maxwellbtyler29/hexapod-robot/docs/README.md

# Docs

| File | What it is |
| --- | --- |
| [`six-leg-setup.md`](six-leg-setup.md) | Current firmware v6 notes, wiring table, and the dated six-leg bring-up log |
| [`control.md`](control.md) | What the walking controller actually does |
| [`bench/`](bench/) | Earlier bench logs: USB/I²C bring-up, one servo, then one leg |
| [`images/`](images/) | Outdoor photo, print renders, and controller screenshots used in the README |

Build and upload steps are in [`../firmware/README.md`](../firmware/README.md).
