maxwellbtyler29/hexapod-robot/docs/images/controller/hexapod-hologram-preview.png

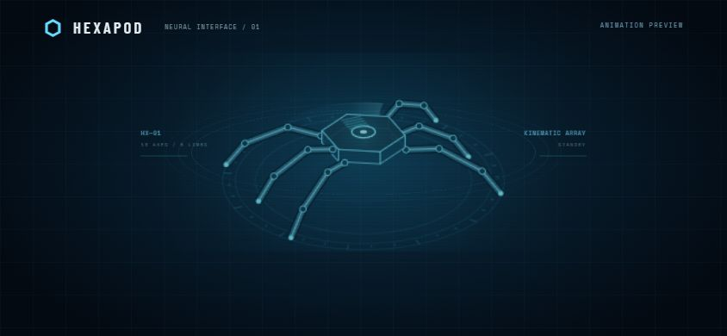
docs/images/controller/hexapod-hologram-preview.png
