maxwellbtyler29/hexapod-robot/docs/images/controller/hexapod-ready-walk-preview.png

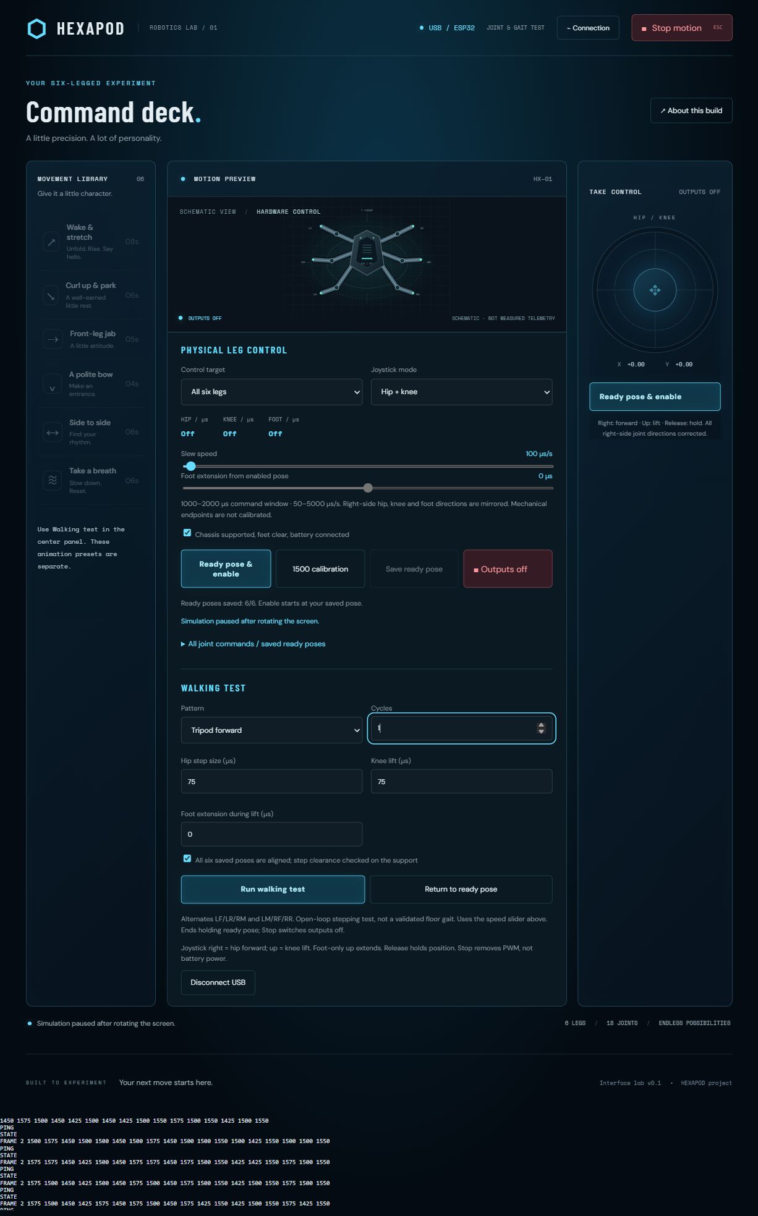
docs/images/controller/hexapod-ready-walk-preview.png
