maxwellbtyler29/hexapod-robot/docs/images/controller/hexapod-startup-preview.png

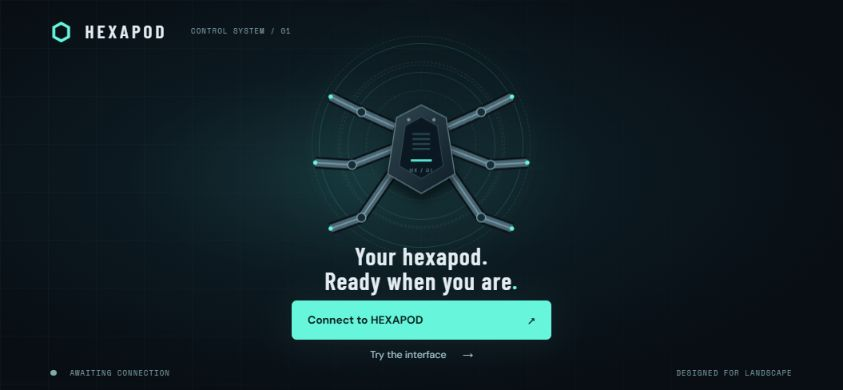
docs/images/controller/hexapod-startup-preview.png
