maxwellbtyler29/hexapod-robot/docs/images/controller/hexapod-usb-controls-preview.png

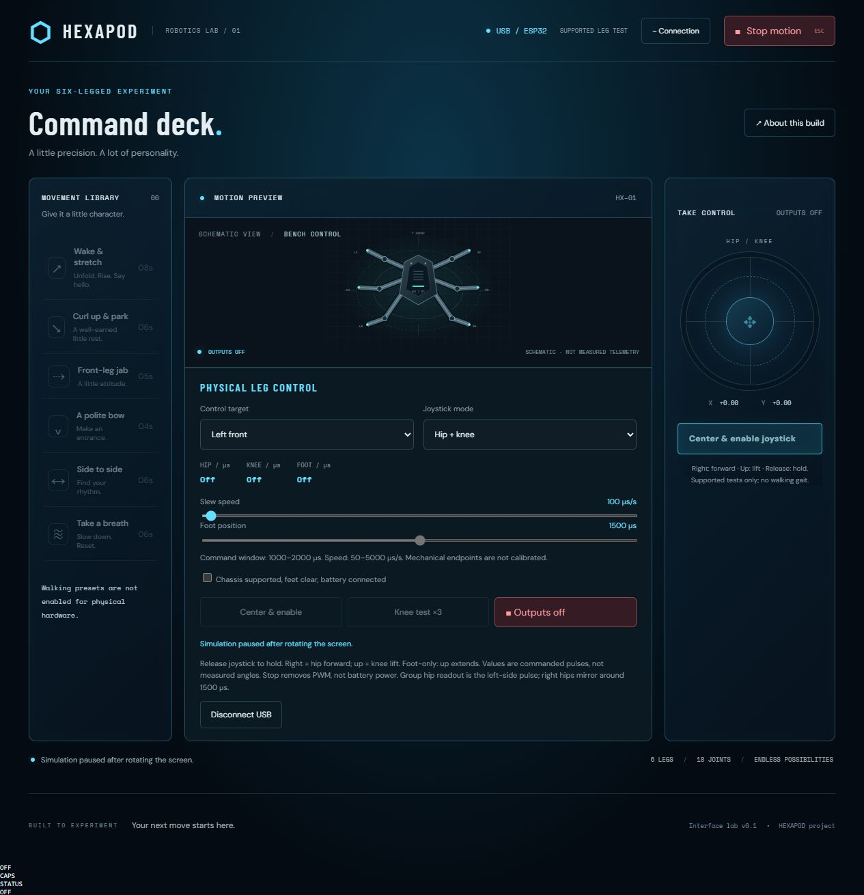
docs/images/controller/hexapod-usb-controls-preview.png
