maxwellbtyler29/hexapod-robot/simulation/gait/trim/peak_torque_comparison.png

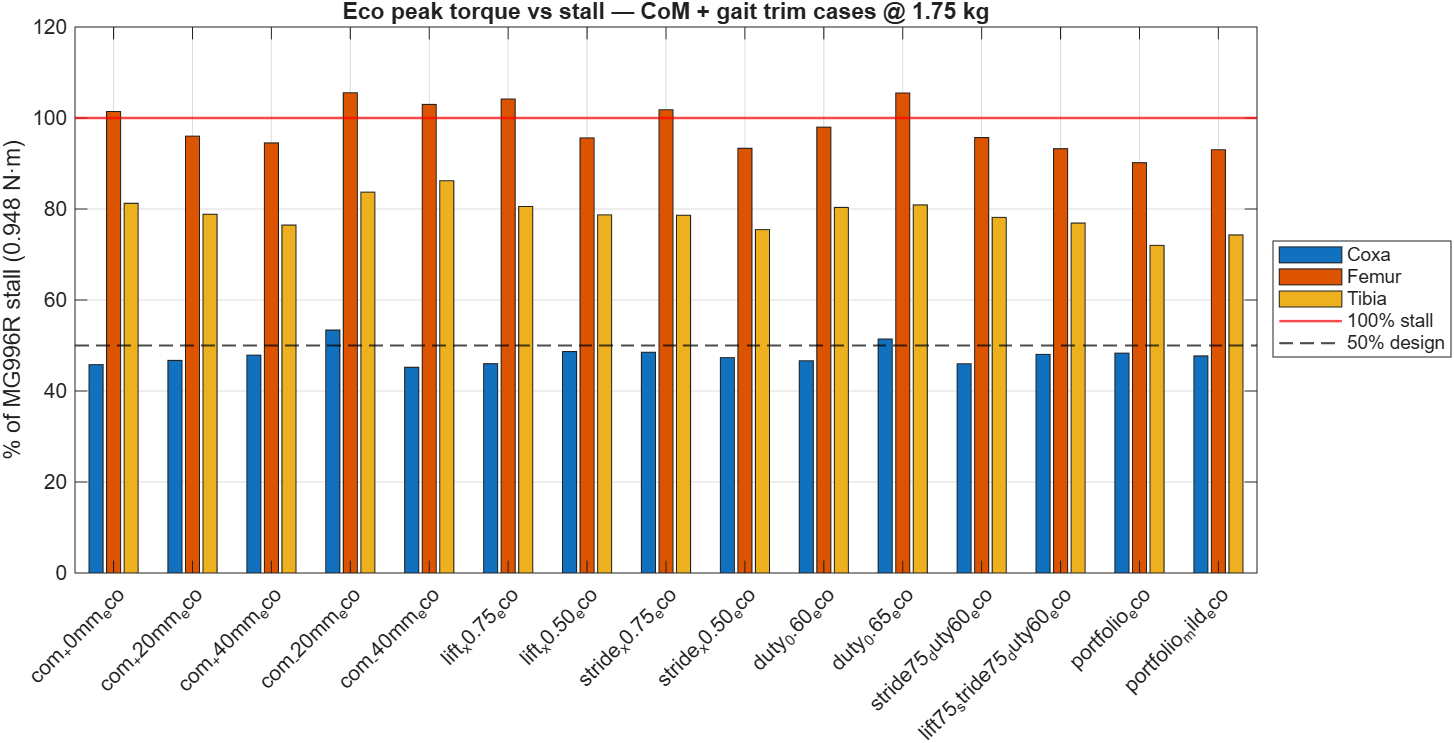
simulation/gait/trim/peak_torque_comparison.png
