maxwellbtyler29/hexapod-robot/cad/assemblies/simscapeHexapodassembly.SLDASM

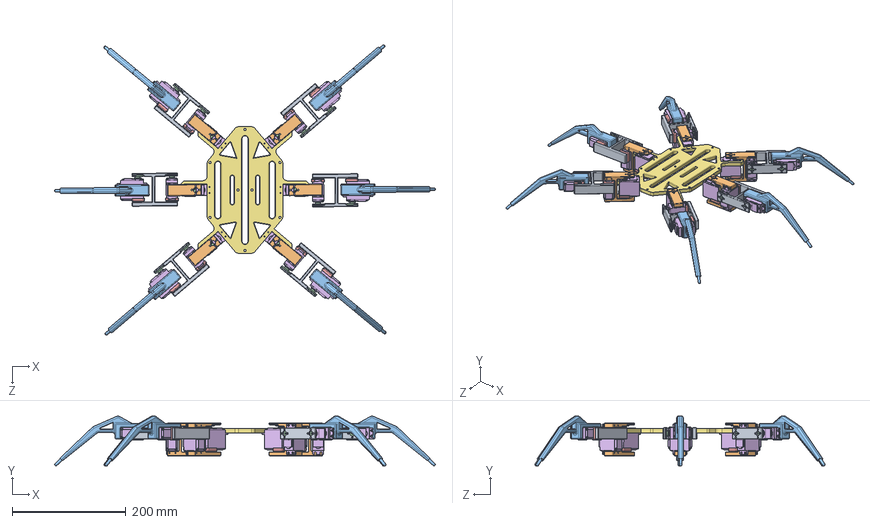
[picture p15: CAD file, 2026-11-10]
cad/assemblies/simscapeHexapodassembly.SLDASM
669.4 x 87.8 x 510.3 mm
Hexapod body (top)
MG996R_servo x 18
Opposite support for servo x 18
Servo Horn x 18
Leg and servo 3 mount x 6
Servo1 to Servo 2 connector x 6
Servo2 to Servo3 Connector x 6
