maxwellbtyler29/hexapod-robot/cad/assemblies/Full Body assembly.SLDASM

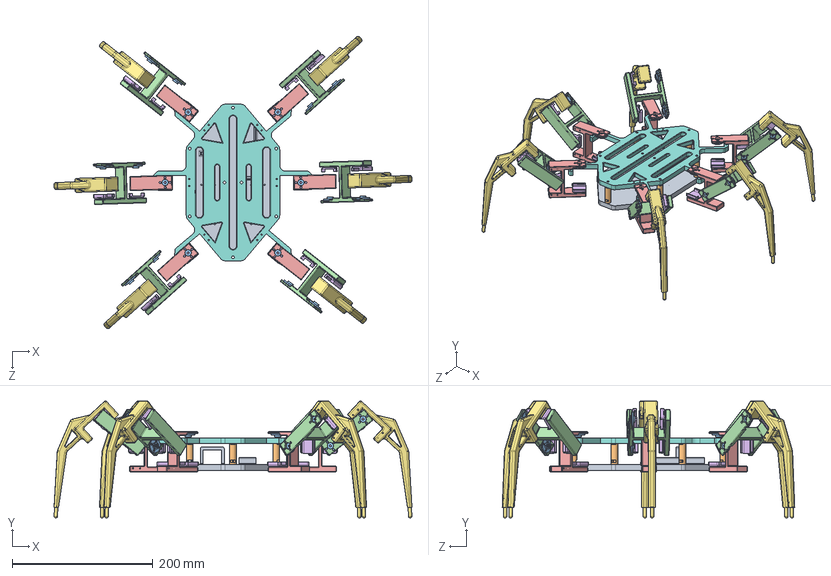
[picture p16: CAD file, 2026-11-10]
cad/assemblies/Full Body assembly.SLDASM
508.6 x 166.0 x 415.5 mm
Hexapod body (top)
Leg and servo 3 mount x 6
Opposite support for servo x 18
Servo1 to Servo 2 connector x 6
Servo2 to Servo3 Connector x 6
Servo Horn x 18
Body Supports x 6
Hexapod body(bottom)
