maxwellbtyler29/hexapod-robot/cad/components/Complete servo assembly.SLDASM

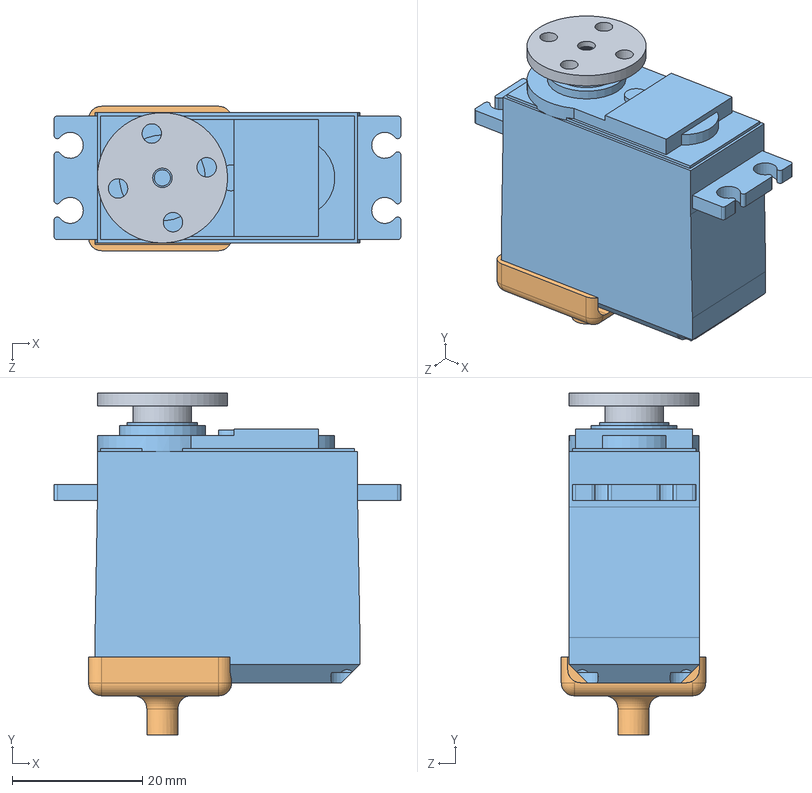
[picture p17: CAD file, 2026-11-10]
cad/components/Complete servo assembly.SLDASM
53.3 x 52.5 x 22.2 mm
MG996R_servo
Opposite support for servo
Servo Horn
