maxwellbtyler29/hexapod-robot/cad/assemblies/One leg assembly.SLDASM

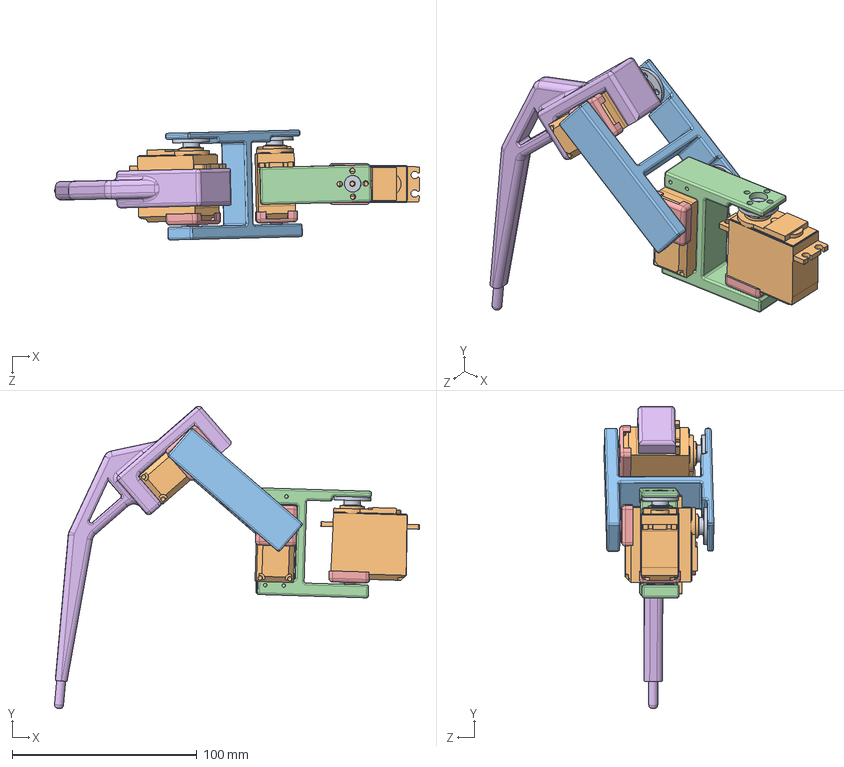
[picture p18: CAD file, 2026-11-10]
cad/assemblies/One leg assembly.SLDASM
197.7 x 163.8 x 59.5 mm
Leg and servo 3 mount
Opposite support for servo x 3
Servo1 to Servo 2 connector
Servo2 to Servo3 Connector
MG996R_servo x 3
Servo Horn x 3
