maxwellbtyler29/hexapod-robot/cad/assemblies/Simscape one leg assembly.SLDASM

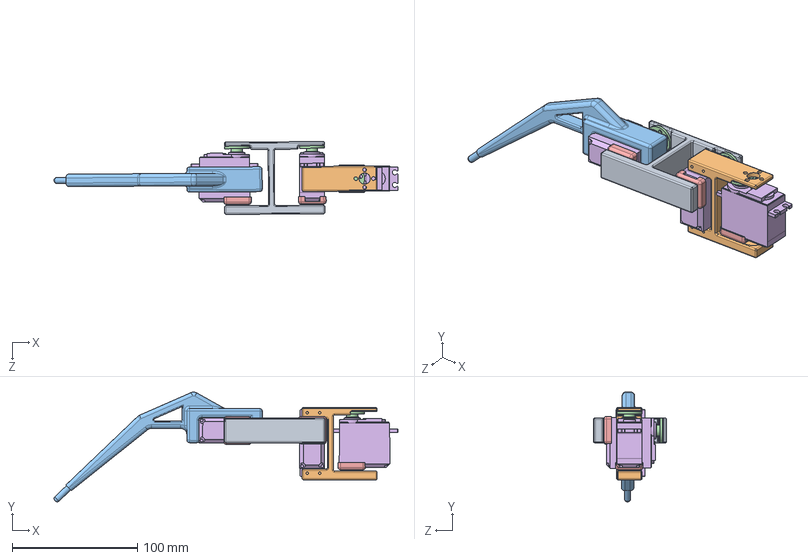
[picture p19: CAD file, 2026-11-10]
cad/assemblies/Simscape one leg assembly.SLDASM
274.9 x 87.8 x 58.3 mm
MG996R_servo x 3
Opposite support for servo x 3
Servo Horn x 3
Leg and servo 3 mount
Servo1 to Servo 2 connector
Servo2 to Servo3 Connector
