maxwellbtyler29/hexapod-robot/cad/components/MG996R_servo.SLDPRT

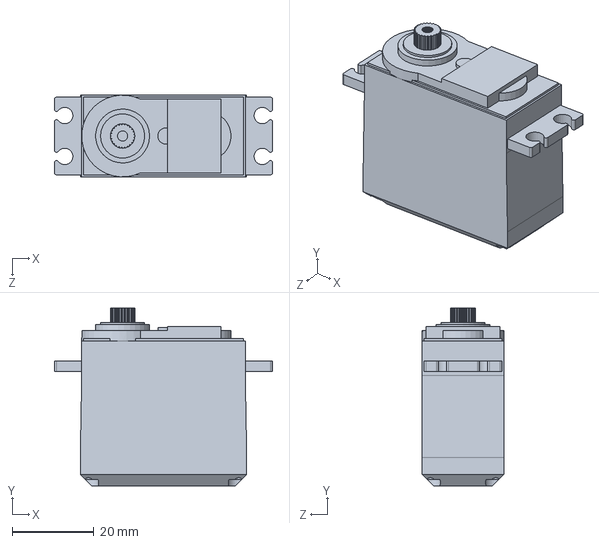
[picture p20: CAD file, 2026-11-10]
cad/components/MG996R_servo.SLDPRT
53.3 x 43.5 x 20.0 mm
