maxwellbtyler29/hexapod-robot/cad/parts/Hexapod body(bottom).SLDPRT

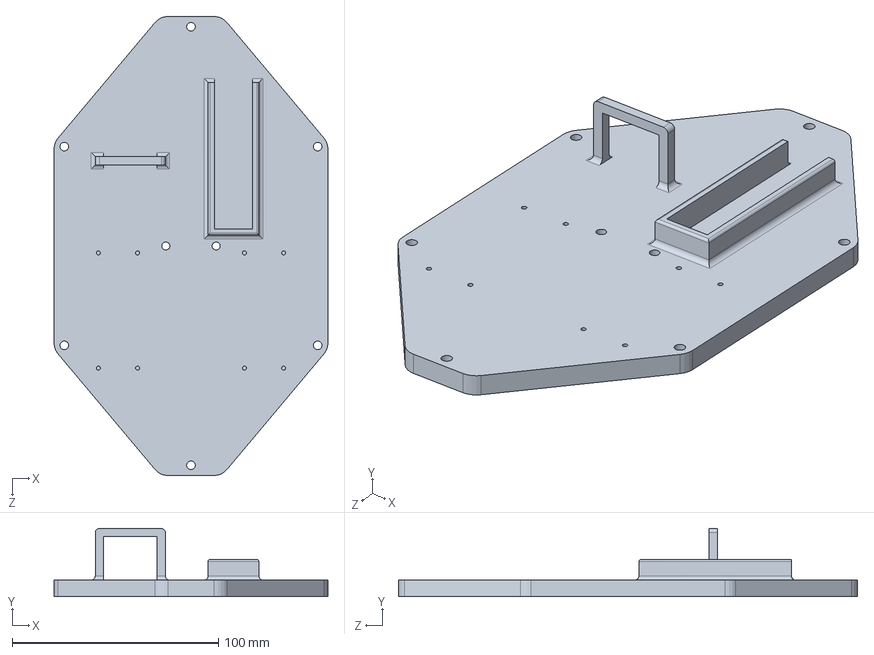
[picture p21: CAD file, 2026-11-10]
cad/parts/Hexapod body(bottom).SLDPRT
132.8 x 33.0 x 222.6 mm
