maxwellbtyler29/hexapod-robot/cad/print/opposite-servo-support.stl

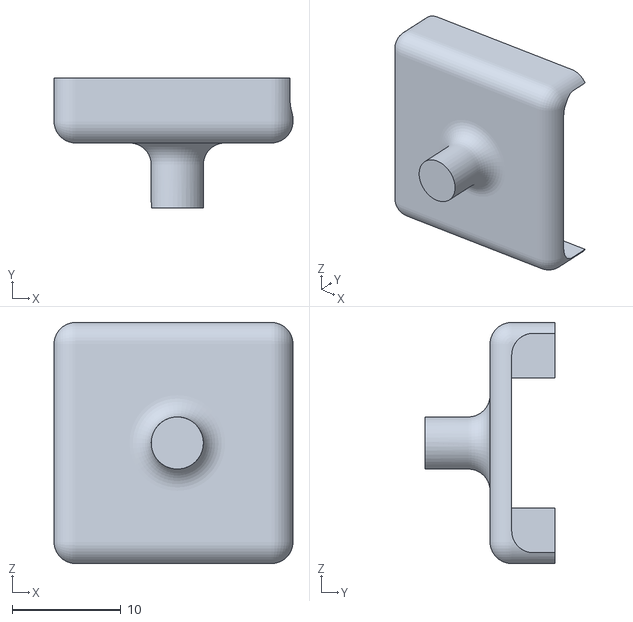
[picture p22: CAD file, 2026-11-10]
cad/print/opposite-servo-support.stl
22.0 x 12.0 x 22.2
