maxwellbtyler29/hexapod-robot/cad/parts/Body Supports.SLDPRT

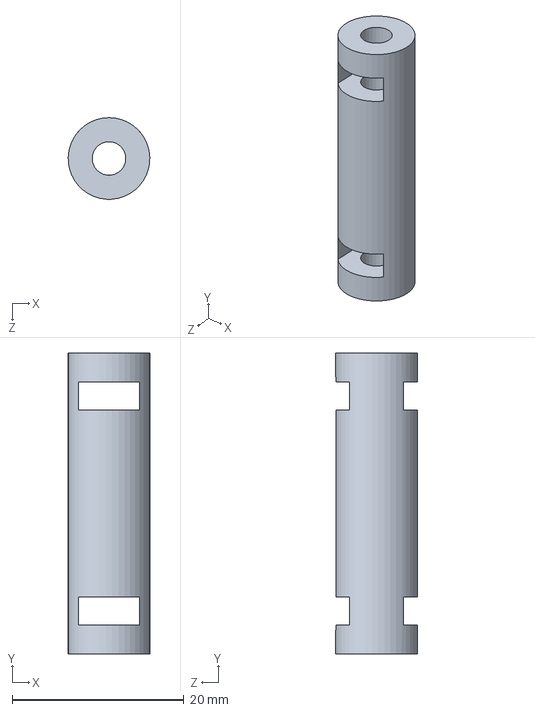
[picture p23: CAD file, 2026-11-10]
cad/parts/Body Supports.SLDPRT
9.49 x 35.0 x 9.50 mm
