maxwellbtyler29/hexapod-robot/cad/print/print-plates.3mf

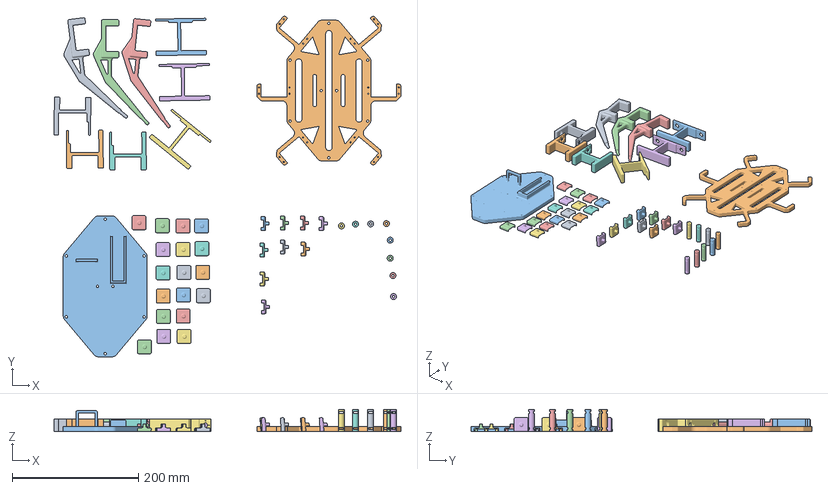
[picture p24: CAD file, 2026-11-10]
cad/print/print-plates.3mf
548.7 x 538.6 x 35.0 mm
leg-and-servo3-mount_mirror.stl x 3
servo1-to-servo2-connector_mirror.stl x 3
servo2-to-servo3-connector_mirror.stl x 3
hexapod-body-top.stl
hexapod-body-bottom.stl
opposite-servo-support.stl x 27
body-supports.stl x 8
