maxwellbtyler29/hexapod-robot/simulation/simscape/servo1-to-servo-2-connector.step

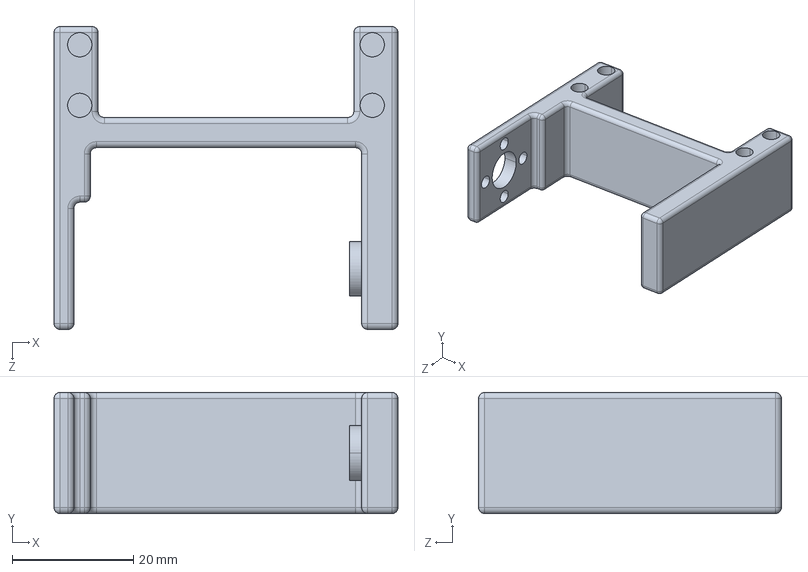
[picture p25: CAD file, 2026-11-10]
simulation/simscape/servo1-to-servo-2-connector.step
56.8 x 20.0 x 50.0 mm
