maxwellbtyler29/hexapod-robot/cad/components/PCA9685.SLDPRT

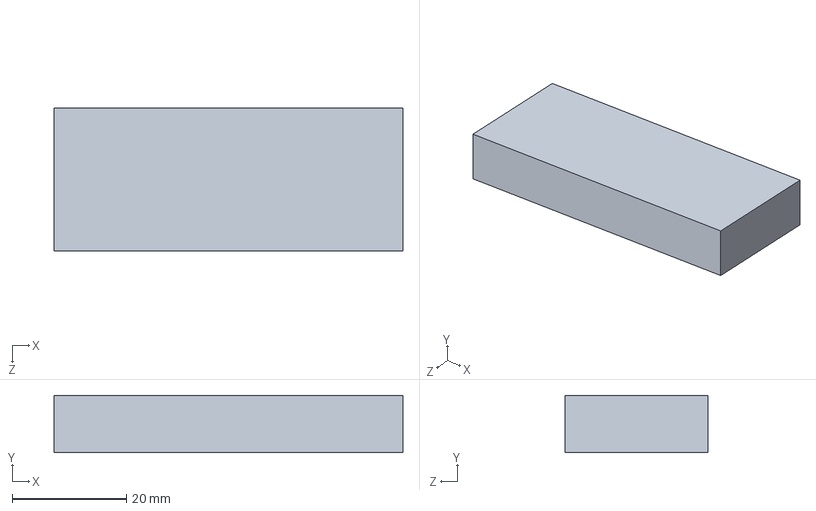
[picture p26: CAD file, 2026-11-10]
cad/components/PCA9685.SLDPRT
61.0 x 10.0 x 25.0 mm
