maxwellbtyler29/hexapod-robot/cad/parts/Leg and servo 3 mount mirror.SLDPRT

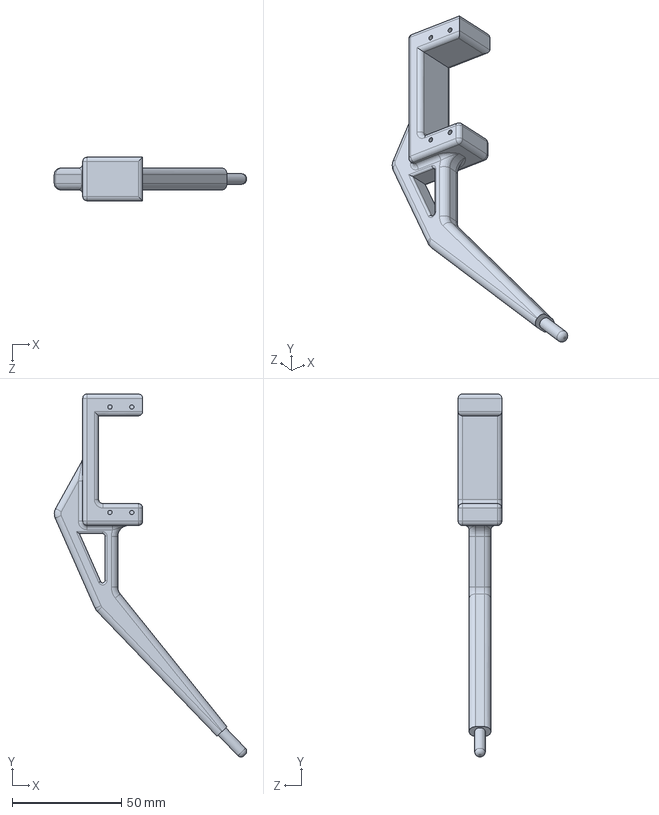
[picture p27: CAD file, 2026-11-10]
cad/parts/Leg and servo 3 mount mirror.SLDPRT
88.2 x 166.2 x 20.0 mm
