maxwellbtyler29/hexapod-robot/cad/print/left-legs-print-plate.3mf

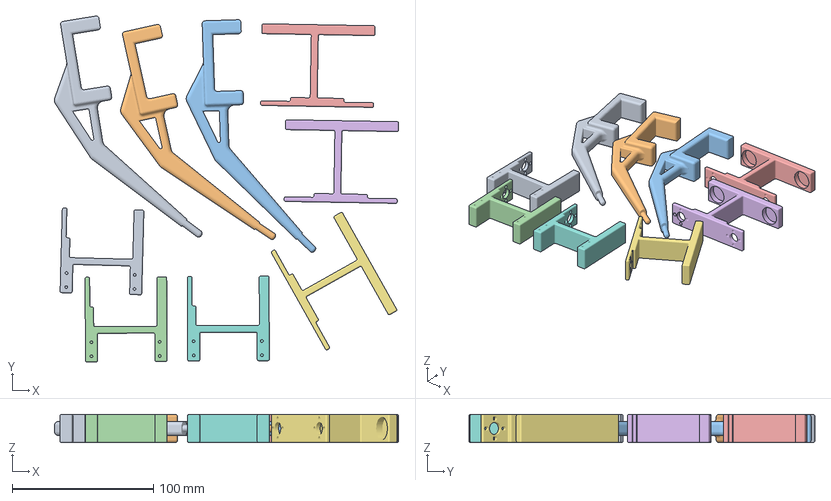
[picture p28: CAD file, 2026-11-10]
cad/print/left-legs-print-plate.3mf
243.6 x 244.8 x 20.0 mm
leg-and-servo3-mount.stl x 3
servo1-to-servo2-connector.stl x 3
servo2-to-servo3-connector.stl x 3
