maxwellbtyler29/hexapod-robot/simulation/simscape/leg-and-servo-3-mount.step

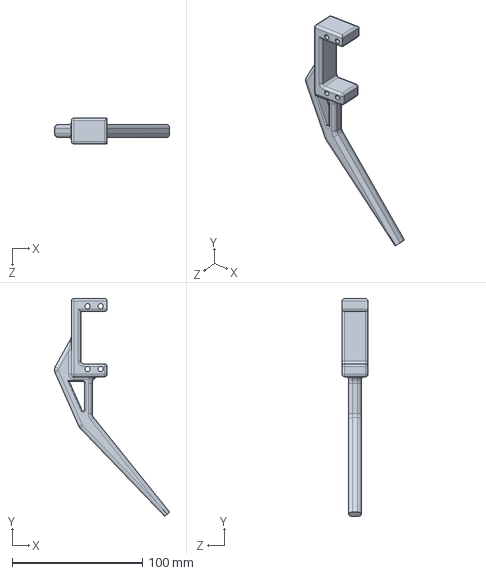
[picture p29: CAD file, 2026-11-10]
simulation/simscape/leg-and-servo-3-mount.step
88.5 x 167.6 x 20.0 mm
