maxwellbtyler29/hexapod-robot/cad/components/SBEC.SLDPRT

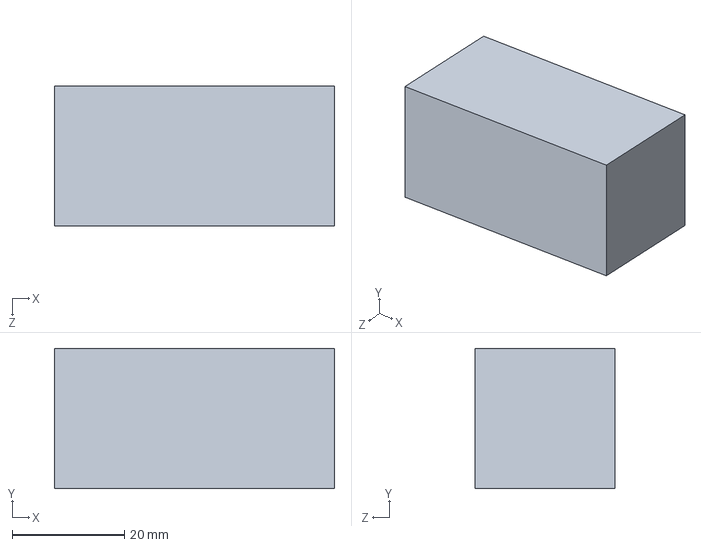
[picture p30: CAD file, 2026-11-10]
cad/components/SBEC.SLDPRT
50.0 x 25.0 x 25.0 mm
