maxwellbtyler29/hexapod-robot/simulation/simscape/hexapod-body-top.step

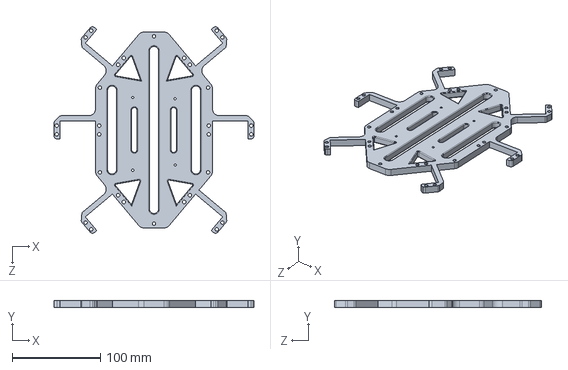
[picture p31: CAD file, 2026-11-10]
simulation/simscape/hexapod-body-top.step
227.2 x 8.00 x 234.7 mm
