maxwellbtyler29/hexapod-robot/cad/components/Battery.SLDPRT

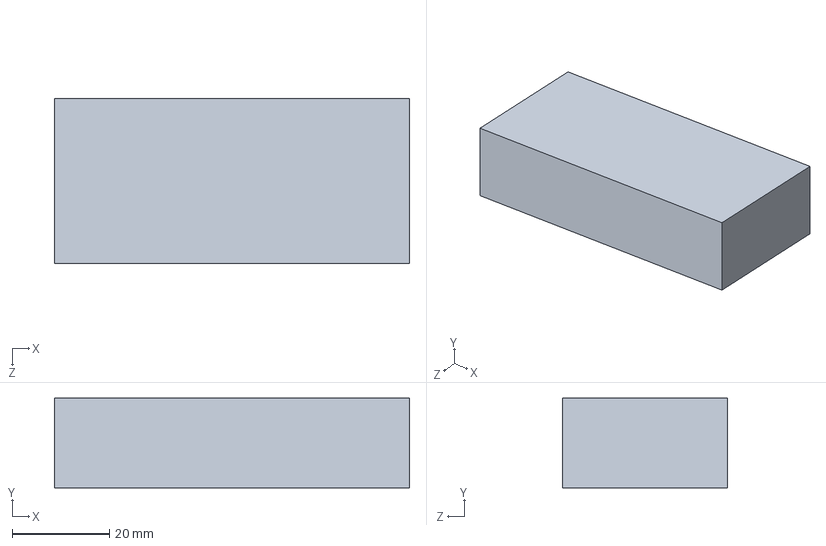
[picture p32: CAD file, 2026-11-10]
cad/components/Battery.SLDPRT
73.0 x 18.5 x 34.0 mm
