maxwellbtyler29/hexapod-robot/cad/parts/Battery Holder.SLDPRT

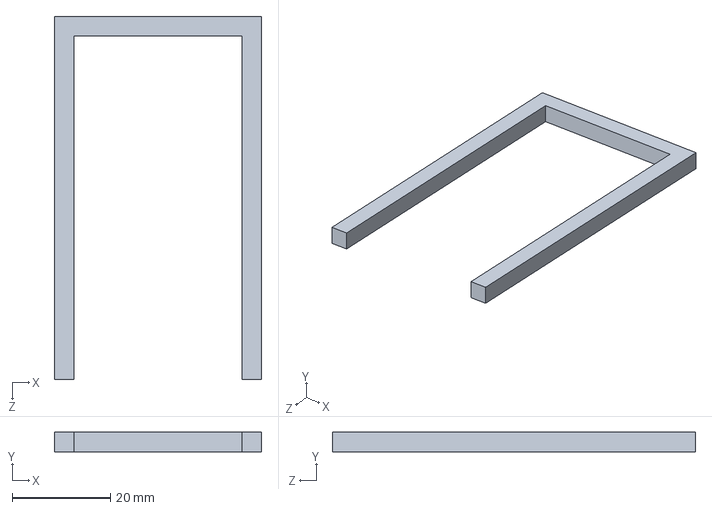
[picture p33: CAD file, 2026-11-10]
cad/parts/Battery Holder.SLDPRT
42.2 x 4.00 x 74.0 mm
