maxwellbtyler29/hexapod-robot/simulation/simscape/servo2-to-servo3-connector.step

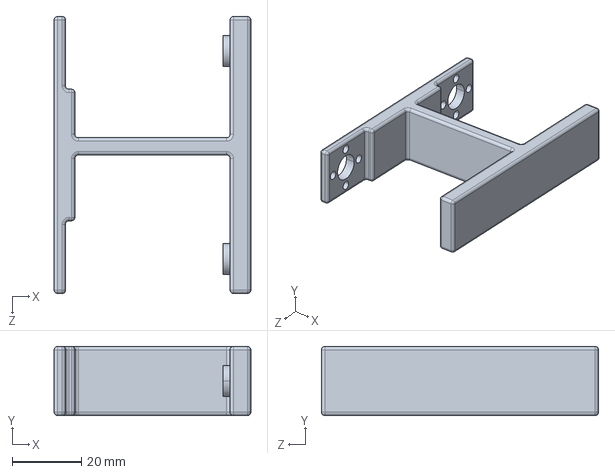
[picture p34: CAD file, 2026-11-10]
simulation/simscape/servo2-to-servo3-connector.step
56.8 x 20.0 x 80.0 mm
