maxwellbtyler29/hexapod-robot/cad/components/ESP32.SLDPRT

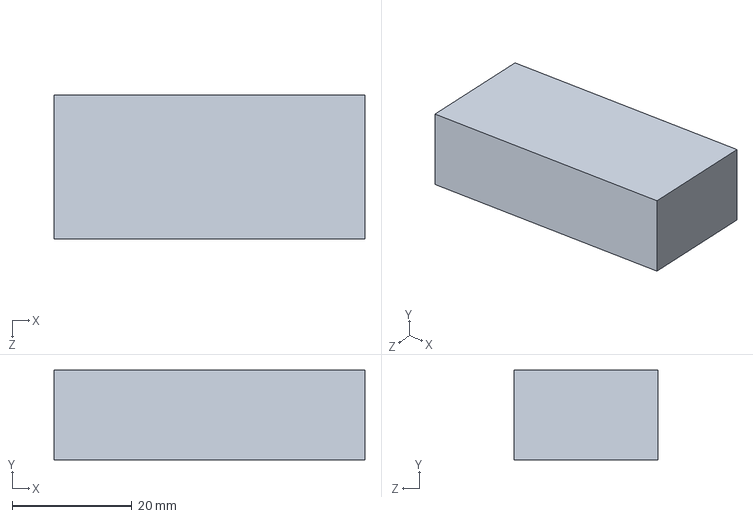
[picture p35: CAD file, 2026-11-10]
cad/components/ESP32.SLDPRT
52.0 x 15.0 x 24.0 mm
