maxwellbtyler29/hexapod-robot/cad/parts/Servo Horn.SLDPRT

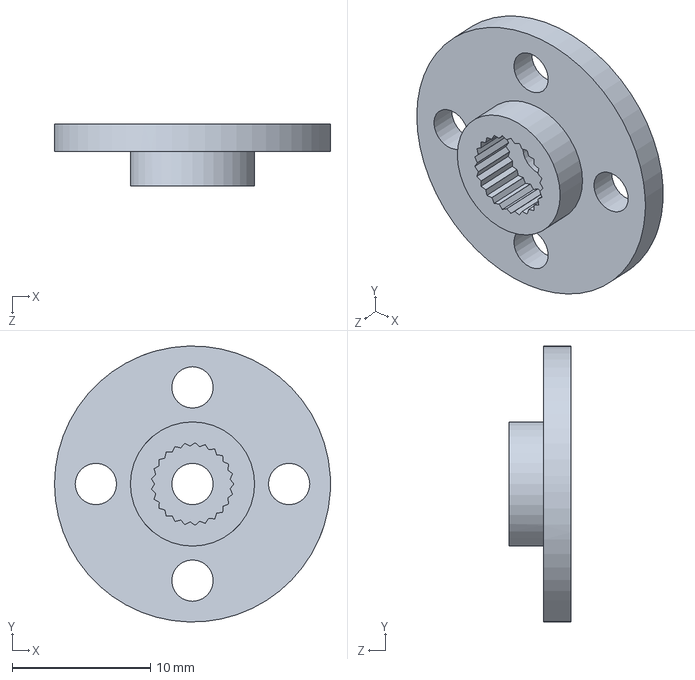
[picture p36: CAD file, 2026-11-10]
cad/parts/Servo Horn.SLDPRT
20.0 x 20.0 x 4.50 mm
