maxwellbtyler29/hexapod-robot/cad/parts/Servo2 to Servo3 Connector mirror.SLDPRT

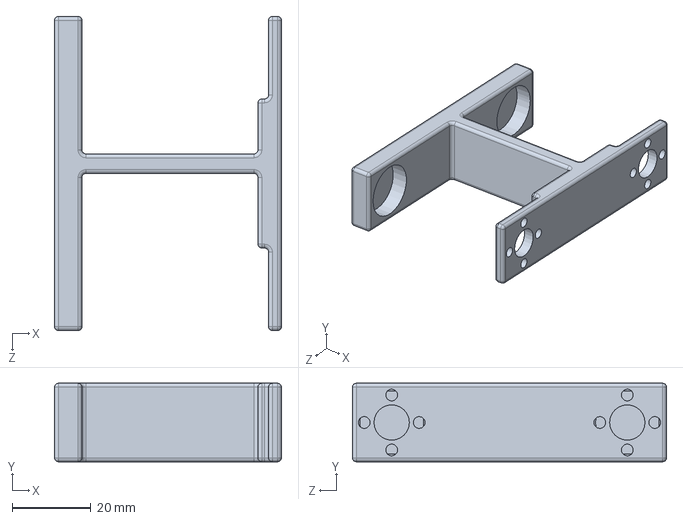
[picture p37: CAD file, 2026-11-10]
cad/parts/Servo2 to Servo3 Connector mirror.SLDPRT
57.8 x 20.0 x 80.0 mm
