maxwellbtyler29/hexapod-robot/simulation/simscape/opposite-support-for-servo.step

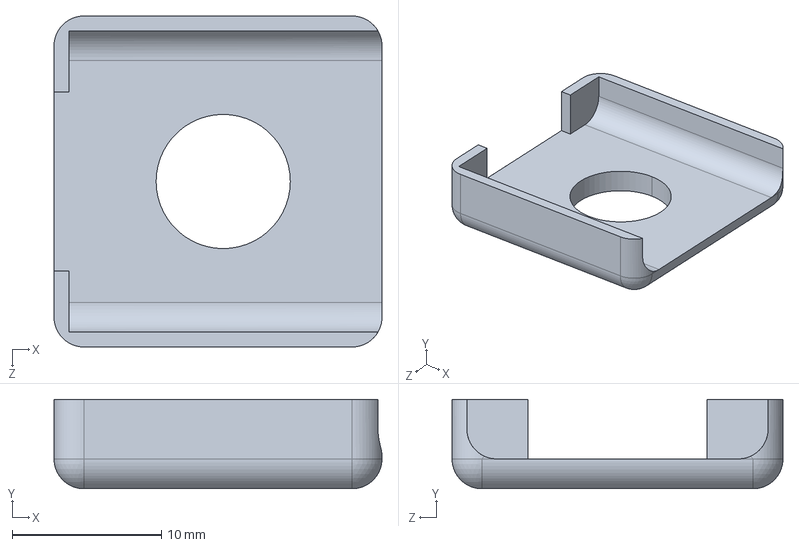
[picture p38: CAD file, 2026-11-10]
simulation/simscape/opposite-support-for-servo.step
22.0 x 6.00 x 22.2 mm
