maxwellbtyler29/hexapod-robot/cad/parts/SBEC Holder.SLDPRT

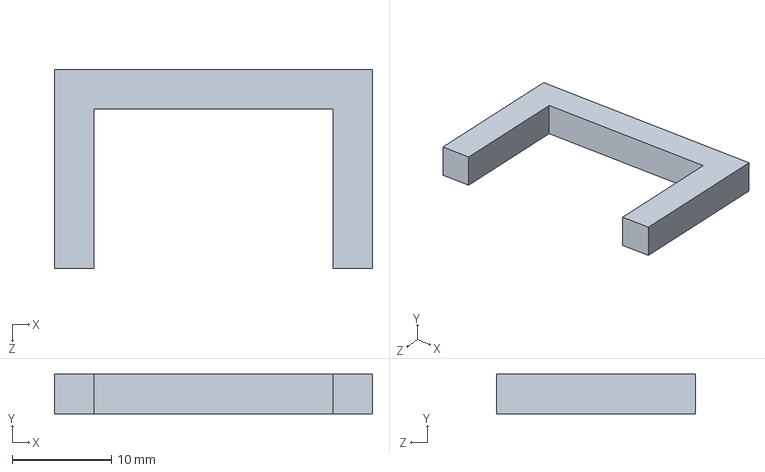
[picture p39: CAD file, 2026-11-10]
cad/parts/SBEC Holder.SLDPRT
32.0 x 4.00 x 20.1 mm
