maxwellbtyler29/hexapod-robot/cad/parts/Hexapod body (top).SLDPRT

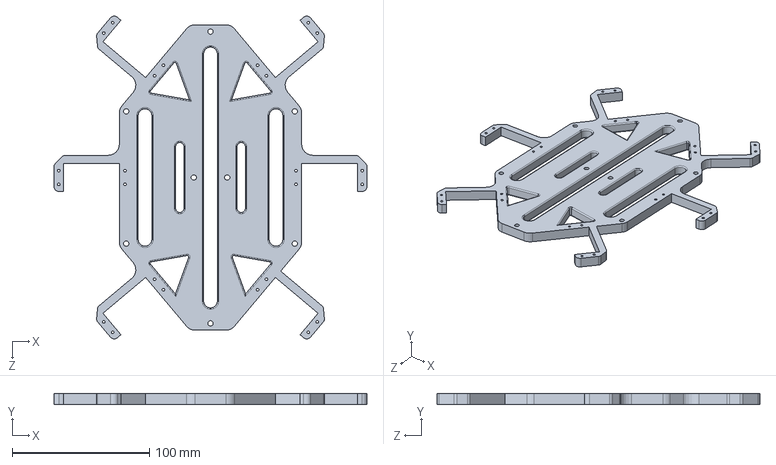
[picture p40: CAD file, 2026-11-10]
cad/parts/Hexapod body (top).SLDPRT
228.0 x 8.00 x 235.2 mm
