maxwellbtyler29/hexapod-robot/cad/parts/ESP32 Mount.SLDPRT

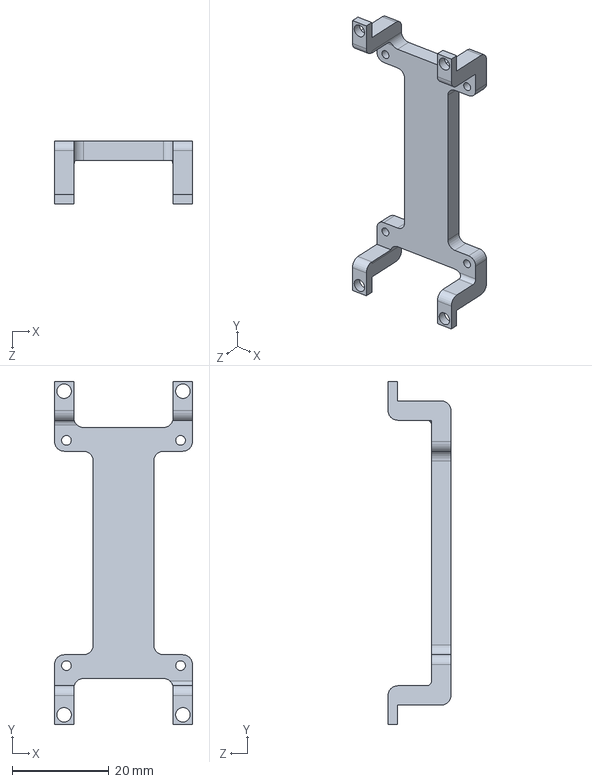
[picture p41: CAD file, 2026-11-10]
cad/parts/ESP32 Mount.SLDPRT
28.5 x 70.8 x 13.0 mm
