maxwellbtyler29/hexapod-robot/cad/parts/Servo1 to Servo 2 connector.SLDPRT

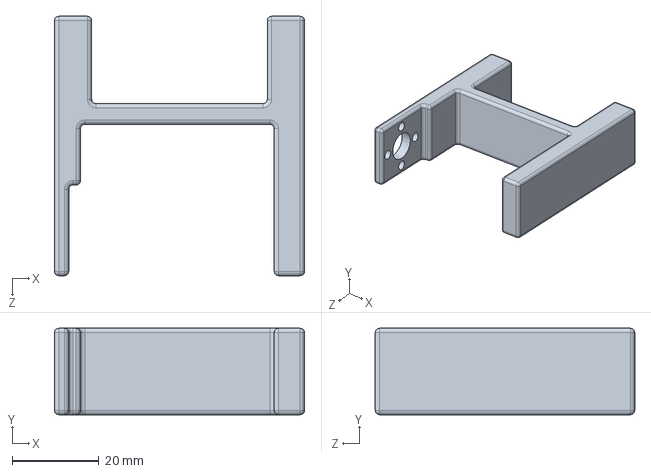
[picture p42: CAD file, 2026-11-10]
cad/parts/Servo1 to Servo 2 connector.SLDPRT
57.8 x 20.0 x 60.0 mm
