maxwellbtyler29/hexapod-robot/(list of files, cad)

Other CAD files:
simulation/simscape/mg996r-servo.step
cad/parts/Opposite support for servo.SLDPRT
simulation/simscape/servo-horn.step
cad/parts/Servo2 to Servo3 Connector.SLDPRT
cad/parts/Servo1 to Servo 2 connector mirror.SLDPRT
cad/parts/Leg and servo 3 mount.SLDPRT
cad/print/body-supports.stl
cad/print/esp32-mount.stl
cad/print/hexapod-body-bottom.stl
cad/print/hexapod-body-top.stl
cad/print/leg-and-servo3-mount.stl
cad/print/leg-and-servo3-mount_mirror.stl
cad/print/servo1-to-servo2-connector.stl
cad/print/servo1-to-servo2-connector_mirror.stl
cad/print/servo2-to-servo3-connector.stl
cad/print/servo2-to-servo3-connector_mirror.stl
