maxwellbtyler29/hexapod-robot/simulation/gait/results/torque_speed_operating_points.png

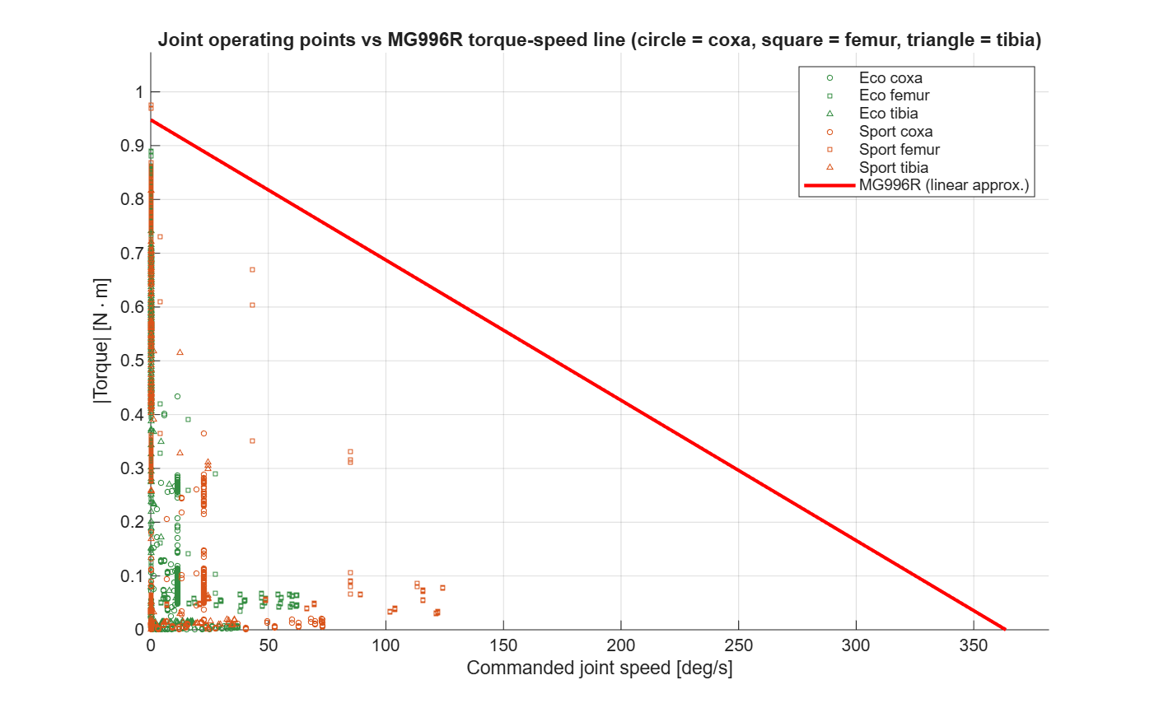
simulation/gait/results/torque_speed_operating_points.png
