maxwellbtyler29/hexapod-robot/controller/tests/hardware-qa.html

⬡ HEXAPOD ROBOTICS LAB / 01

SIMULATION NO HARDWARE CONNECTED

■ Outputs offESC

YOUR SIX-LEGGED EXPERIMENT

# Command deck.

A little precision. A lot of personality.

↗ About this build

## Movement library

06

Give it a little character.

Browser simulation
Explore freely. No servo commands.

## Motion preview

P3DRO

SCHEMATIC VIEW / TRIPOD

STANDBYILLUSTRATIVE MOTION / NOT LIVE IK

REQUESTED SPEED0.0 mm/s

GAIT PATTERNTripod 3 + 3

OUTPUTSimulation only

GAIT PHASE

IDLE

## Take control

PAUSED

MOVEMENT MODE

SPEED LIMIT50%

PRECISEPLAYFUL

FORWARD

✥

X +0.00Y +0.00

Enable simulation →

Drag to move · release to center

Ready when you are. Enable simulation to explore.

6 LEGS / 18 JOINTS / ENDLESS POSSIBILITIES

BUILT TO EXPERIMENT

Your next move starts here.

P3DRO • HEXAPOD project

×P3DRO

## A new home for your robot.

This command deck explores the UI for your HEXAPOD project. The joystick and routines animate a browser schematic until the page is connected to the ESP32. They do not measure joint angles.

P3DRO walks in Eco and Sport from the phone deck. Camera, battery-voltage sensing, and odometry stay unavailable until that hardware is connected.

Back to the deck →
