maxwellbtyler29/hexapod-robot/firmware/deck/calibration.html

⬡HEXAPODP3DRO / CALIBRATION

OFFLINE OUTPUTS OFF ■ Outputs off

Recover

01 / JOINTS—

Tap a joint. It energises at its saved ready pulse (no jump to 1500) and every other powered joint keeps holding. ✓R = ready pulse saved, ✓D = direction checked.

Hold all at ready Connect

02 / SELECTED JOINTNONE

— µs

saved —limits —

−50−10−2−1 +1+2+10+50

The servo boards step in ≈4.9 µs increments, so ±1/±2 nudges are saved exactly but may only move the horn every few presses.

Save as ready pulseRelease this joint

DIRECTION

Hip +: foot swings toward the head. Knee +: foot lifts. Foot +: foot tucks inward.

Wiggle + (40 µs) Invert this joint

Direction is correct — save

LIMITS

MINMAXSave limits

Limits only need to contain this joint's ready pulse (they no longer have to include 1500).

Connect to begin.

03 / ONE-CYCLE TESTS0 RUN HERE

Chassis supported, feet clear. Needs all 18 servos holding at ready ("Hold all at ready", then wait). Any calibration change clears the tests.

Forward — Backward — Crab left — Crab right —

04 / GAIT TUNING—

STRIDE µsLIFT µs FOOT TUCK µsCRAB REACH µs CRAB KNEE MIX %ECO CYCLE ms SPORT CYCLE msSIT DEPTH µs

Save gait settingsDefaults

BACKUP

Download backupRestore backup
