maxwellbtyler29/hexapod-robot/simulation/gait/results/summary_gait_timing.csv

mode | leg | cycle_cmd_s | cycle_meas_s | duty_cmd | duty_meas | touchdown_phase_cmd | touchdown_phase_meas | liftoff_phase_cmd | liftoff_phase_meas | clearance_mm | stride_mm | slip_per_step_mm | steps_analysed
Eco | LF | 2.400 | 2.400 | 0.560 | 0.565 | 0.000 | 0.025 | 0.560 | 0.590 | 22.2 | 26.5 | 23.45 | 3
Eco | LM | 2.400 | 2.400 | 0.560 | 0.554 | 0.000 | 0.033 | 0.560 | 0.587 | 22.7 | 36.1 | 1.10 | 3
Eco | LR | 2.400 | 2.400 | 0.560 | 0.564 | 0.000 | 0.029 | 0.560 | 0.592 | 22.3 | 26.3 | 23.83 | 3
Eco | RF | 2.400 | 2.400 | 0.560 | 0.565 | 0.000 | 0.025 | 0.560 | 0.590 | 22.2 | 26.2 | 23.45 | 3
Eco | RM | 2.400 | 2.400 | 0.560 | 0.554 | 0.000 | 0.033 | 0.560 | 0.587 | 22.7 | 36.4 | 1.10 | 3
Eco | RR | 2.400 | 2.400 | 0.560 | 0.564 | 0.000 | 0.029 | 0.560 | 0.592 | 22.3 | 26.0 | 23.83 | 3
Sport | LF | 1.200 | 1.200 | 0.560 | 0.520 | 0.000 | 0.083 | 0.560 | 0.602 | 22.2 | 25.3 | 21.59 | 3
Sport | LM | 1.200 | 1.200 | 0.560 | 0.508 | 0.000 | 0.094 | 0.560 | 0.602 | 22.7 | 34.0 | 0.12 | 3
Sport | LR | 1.200 | 1.200 | 0.560 | 0.517 | 0.000 | 0.090 | 0.560 | 0.606 | 22.2 | 24.8 | 22.62 | 3
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
