maxwellbtyler29/hexapod-robot/simulation/gait/results/summary_torque.csv

mode | leg | joint | peak_Nm | rms_Nm | standing_Nm | peak_pct_of_stall
Eco | LF | coxa | 0.1983 | 0.0702 | 0.0000 | 20.9
Eco | LF | femur | 0.3516 | 0.2191 | 0.2823 | 37.1
Eco | LF | tibia | 0.1475 | 0.0333 | 0.1885 | 15.6
Eco | LM | coxa | 0.4340 | 0.2003 | 0.0000 | 45.8
Eco | LM | femur | 0.9616 | 0.5454 | 0.2825 | 101.4
Eco | LM | tibia | 0.7298 | 0.3419 | 0.1886 | 77.0
Eco | LR | coxa | 0.2054 | 0.0711 | 0.0000 | 21.7
Eco | LR | femur | 0.9180 | 0.5260 | 0.2827 | 96.8
Eco | LR | tibia | 0.7703 | 0.4424 | 0.1888 | 81.3
Eco | RF | coxa | 0.1983 | 0.0702 | 0.0000 | 20.9
Eco | RF | femur | 0.3516 | 0.2191 | 0.2822 | 37.1
Eco | RF | tibia | 0.1475 | 0.0333 | 0.1885 | 15.6
Eco | RM | coxa | 0.4341 | 0.2003 | 0.0000 | 45.8
Eco | RM | femur | 0.9604 | 0.5453 | 0.2825 | 101.3
Eco | RM | tibia | 0.7281 | 0.3418 | 0.1886 | 76.8
Eco | RR | coxa | 0.2053 | 0.0711 | 0.0000 | 21.7
Eco | RR | femur | 0.9180 | 0.5260 | 0.2827 | 96.8
Eco | RR | tibia | 0.7703 | 0.4425 | 0.1888 | 81.3
Sport | LF | coxa | 0.2214 | 0.0665 | 0.0000 | 23.4
Sport | LF | femur | 0.3647 | 0.2241 | 0.2823 | 38.5
Sport | LF | tibia | 0.1848 | 0.0345 | 0.1885 | 19.5
Sport | LM | coxa | 0.4910 | 0.1981 | 0.0000 | 51.8
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
