maxwellbtyler29/hexapod-robot/simulation/gait/results/body_motion.png

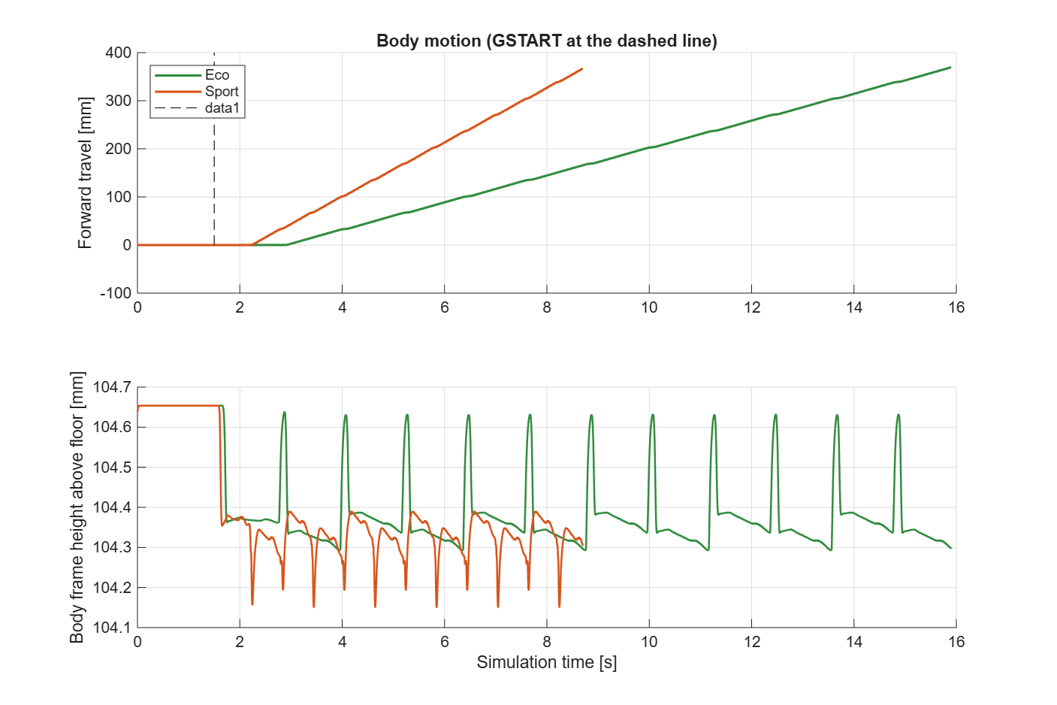
simulation/gait/results/body_motion.png
