maxwellbtyler29/hexapod-robot/simulation/gait/results/foot_paths_eco.png

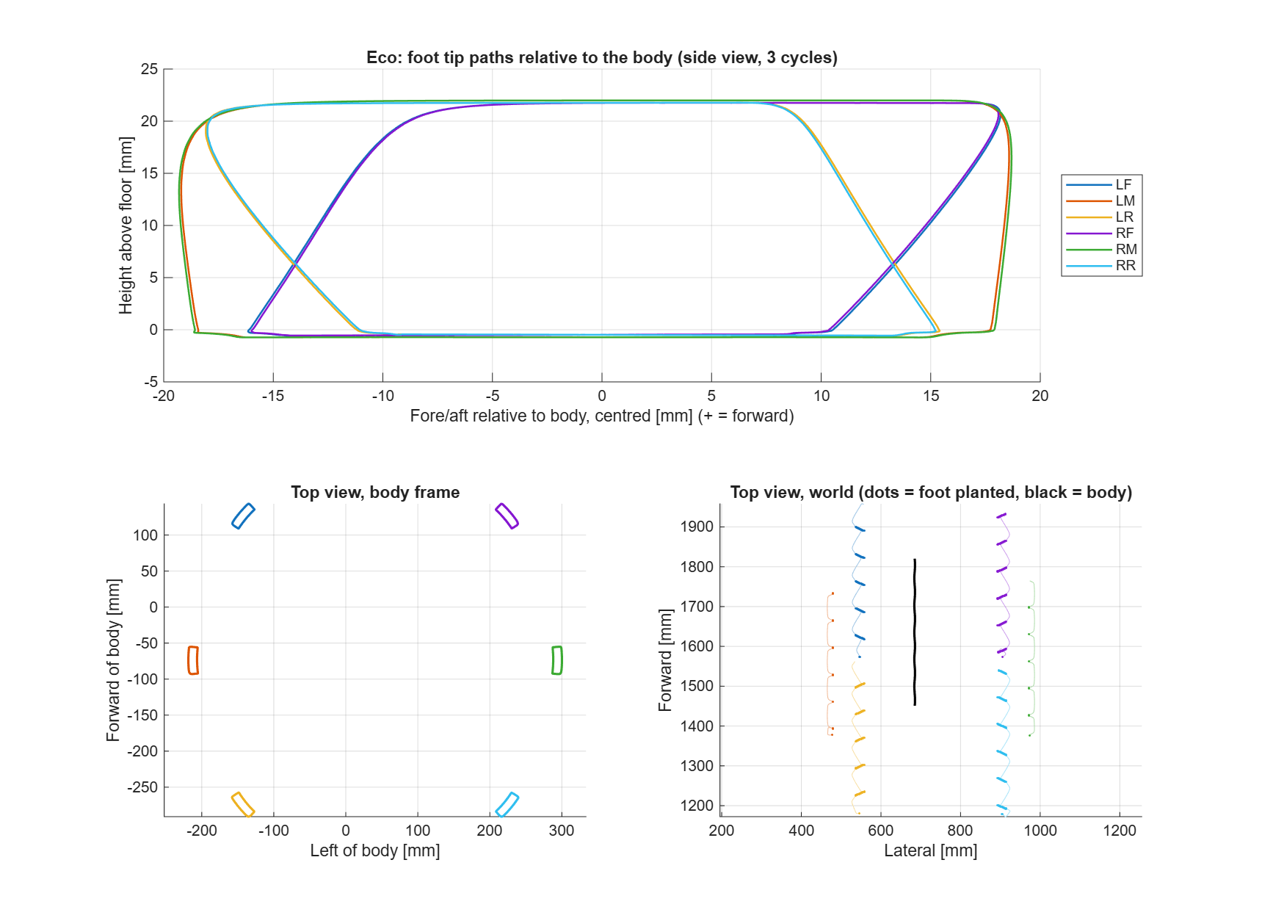
simulation/gait/results/foot_paths_eco.png
