maxwellbtyler29/hexapod-robot/simulation/gait/results/foot_paths_sport.png

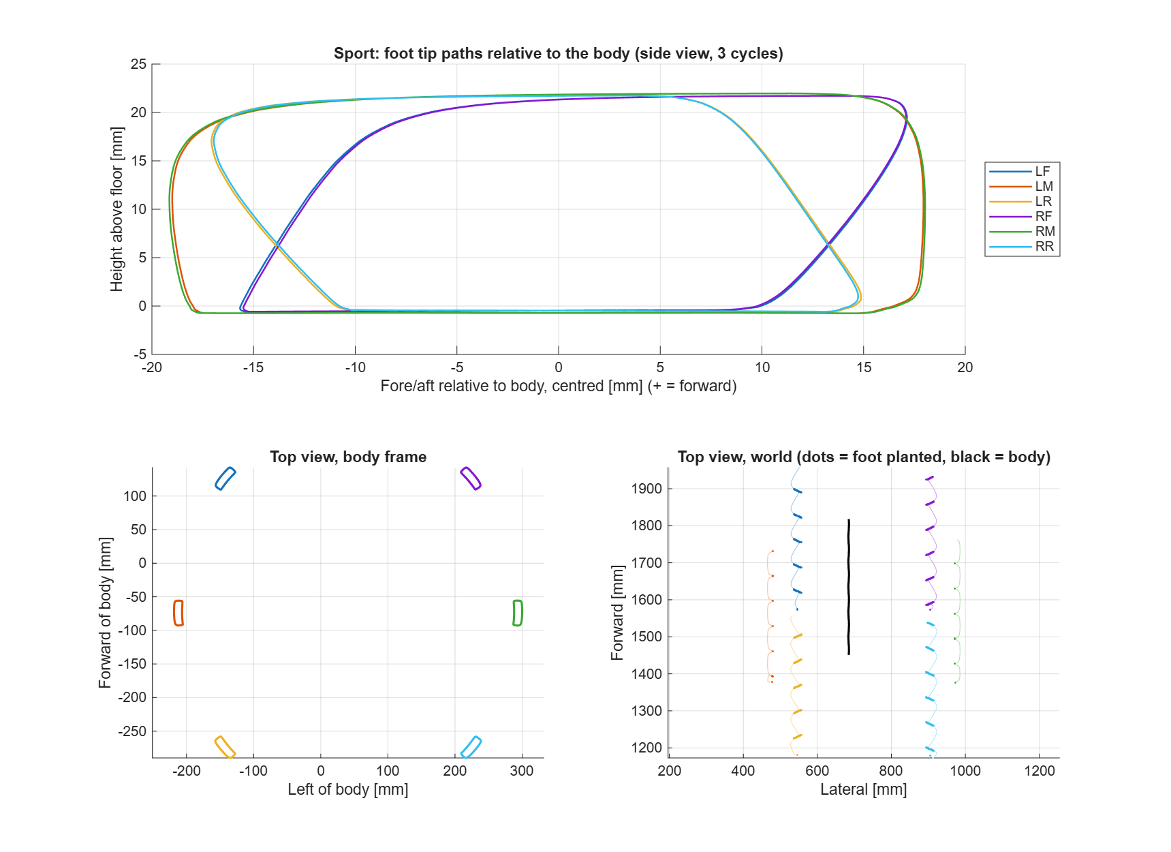
simulation/gait/results/foot_paths_sport.png
