maxwellbtyler29/hexapod-robot/simulation/gait/results/gait_phase_eco.png

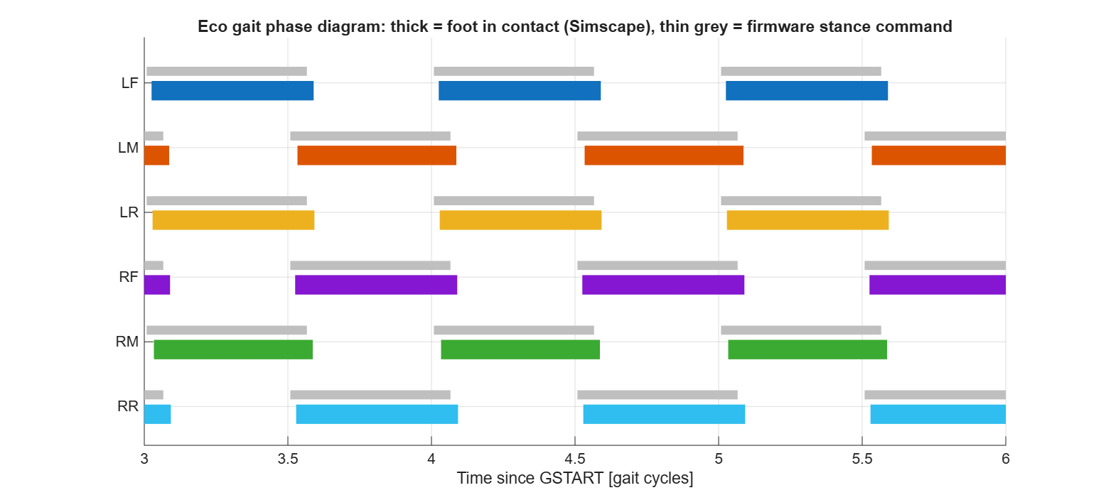
simulation/gait/results/gait_phase_eco.png
