maxwellbtyler29/hexapod-robot/simulation/gait/results/peak_torque_vs_stall.png

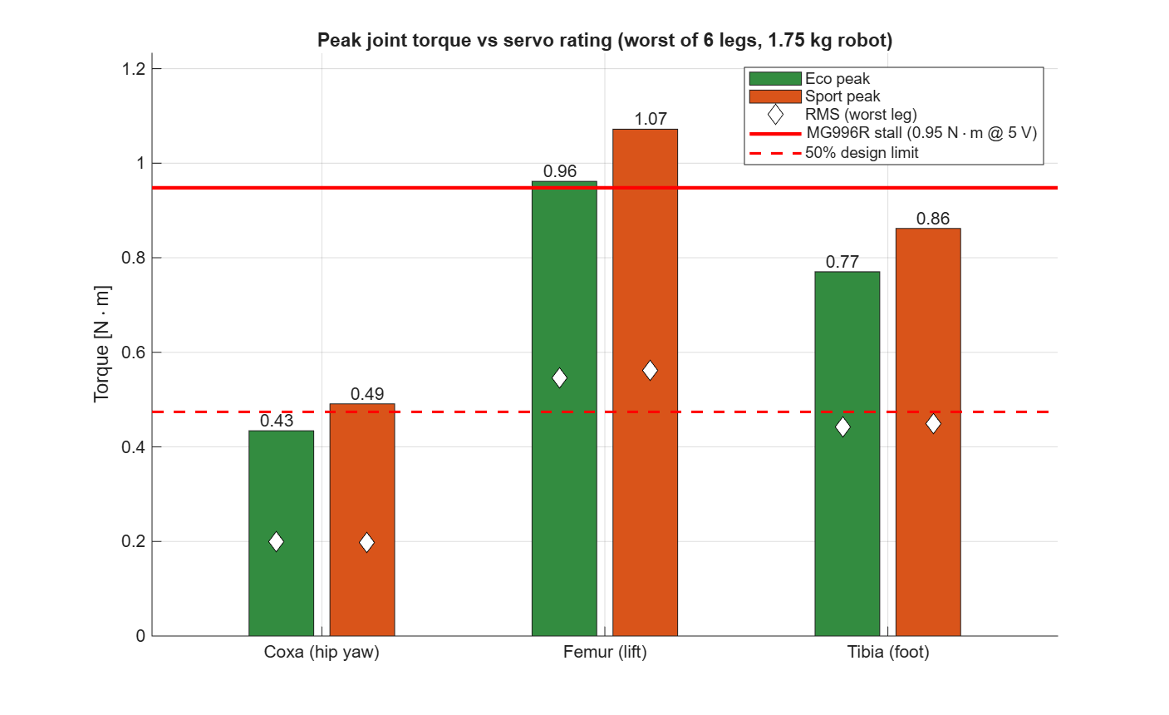
simulation/gait/results/peak_torque_vs_stall.png
