maxwellbtyler29/hexapod-robot/simulation/gait/results/torque_vs_time_sport.png

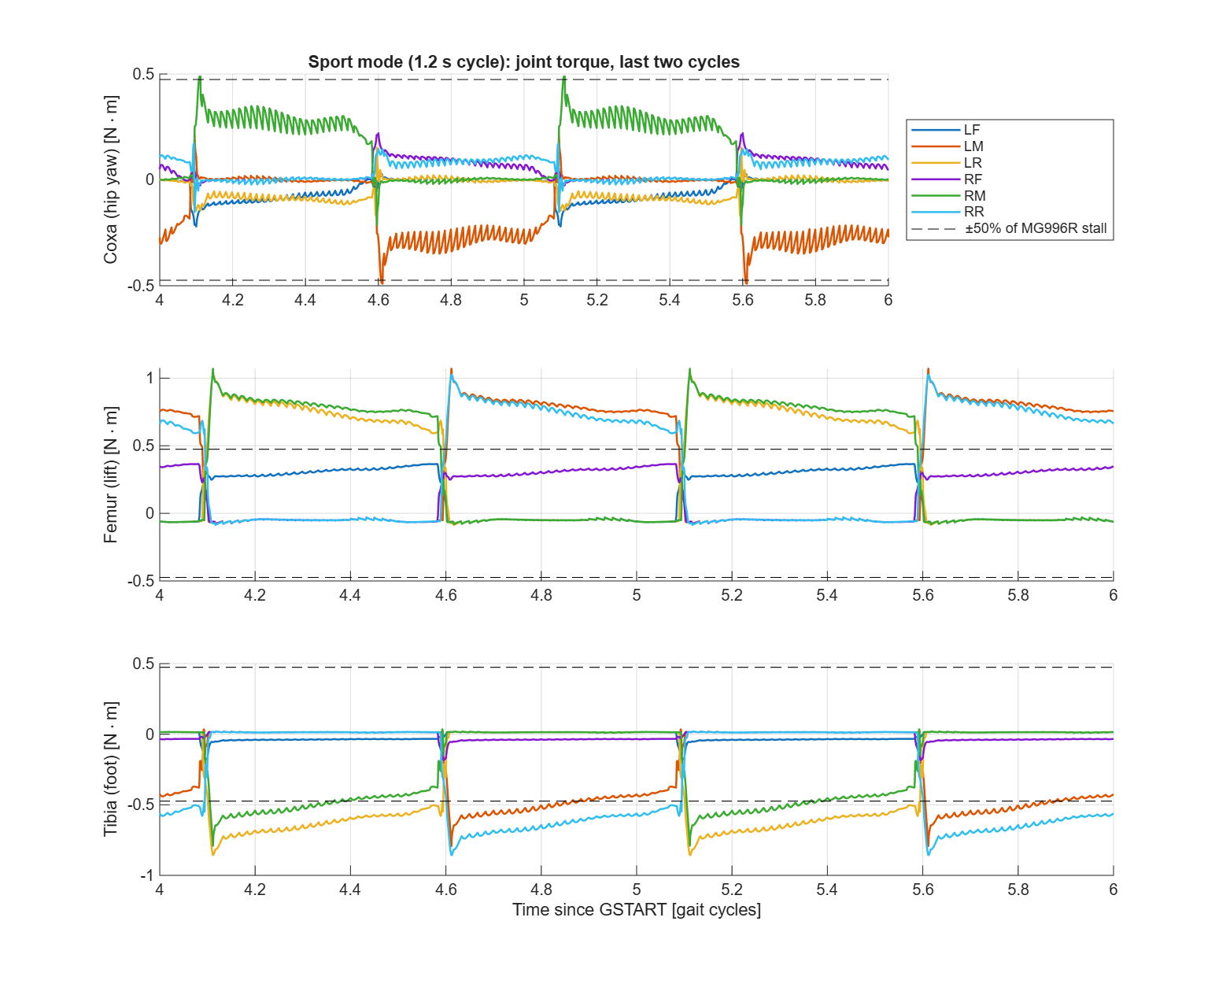
simulation/gait/results/torque_vs_time_sport.png
