maxwellbtyler29/hexapod-robot/firmware/src/wifi_secrets.example.h

#pragma once
// Copy this file to wifi_secrets.h (git-ignored) and set your own access-point
// password (8+ characters). The real password is intentionally not committed.
#define HEXAPOD_AP_SSID "Hexapod-Control"
#define HEXAPOD_AP_PASSWORD "CHANGE_ME_PASSWORD"
