maxwellbtyler29/hexapod-robot/(commit log)

2026-11-10 Add the printed structure and the purchased-part models.
    Body plates, leg brackets, holders, and the MG996R, ESP32, PCA9685, SBEC, and battery models used to package the robot.
    [Battery Holder.SLDPRT, Battery.SLDPRT, Body Supports.SLDPRT, Complete servo assembly.SLDASM, ESP32 Mount.SLDPRT, ESP32.SLDPRT, Hexapod body (top).SLDPRT, Hexapod body(bottom).SLDPRT]
2026-11-10 Add the body and leg assemblies and the files that were printed.
    Full-body and one-leg assemblies, STL exports, and the Bambu Studio plates. SolidWorks filenames stay as they were saved so the assemblies can still find their parts.
    [Full Body assembly.SLDASM, One leg assembly.SLDASM, Simscape one leg assembly.SLDASM, body-supports.stl, esp32-mount.stl, hexapod-body-bottom.stl, hexapod-body-top.stl, left-legs-print-plate.3mf]
2026-11-10 Add MATLAB leg kinematics.
    Inverse and forward kinematics, a foot path, and a fixed-body preview used to check reach before the multibody model.
2026-11-10 Add the Simscape standing model exported from the assembly.
    STEP geometry and the Multibody Link data. The gait study copies this model and does not modify it.
    [hexapod-body-top.step, leg-and-servo-3-mount.step, mg996r-servo.step, opposite-support-for-servo.step, servo-horn.step, servo1-to-servo-2-connector.step, servo2-to-servo3-connector.step]
2026-11-10 Add the ESP32 firmware, phone deck, and one-leg inverse kinematics.
    Tripod gait on a 20 ms tick, calibration stored in flash, bring-up programs, and a desktop geometry preview.
2026-11-10 Add Hexapod Command, the browser controller.
    USB serial and Wi-Fi pages. The calibration page keeps only the files that differ from the shared scripts.
2026-11-10 Add the Simscape study of the firmware tripod gait.
    Ports the walking gait onto a free-body copy of the standing model so torque, foot paths, and timing can be recorded.
2026-11-10 Record the gait study at the weighed 1.75 kg mass.
    Eco and Sport summaries and plots. The center-of-mass comparison stays; the +40 mm battery move was not built.
    [comparison_table.csv, summary_gait_timing.csv, summary_torque.csv]
2026-11-10 Add the bench logs and the six-leg commissioning notes.
    USB, one-servo, and one-leg bring-up, then the wiring and calibration record for the walking firmware.
2026-11-10 Add the outdoor photo and the project README.
    P3DRO walks outdoors in Eco and Sport on the MG996Rs. Measured mass is 1.75 kg, and the bare printed foot tips walked better than the rubber caps.
